victorkolesnyk/trickymonkey/yacht/README.md

# ВК-90: вітрильний крейсер 9,0 м із фанери

Робочий шифр ВК-90. Стан: ескізний проєкт, ревізія 0, не для виробництва.

- `docs/01_tekhnichne_zavdannia.md`: технічне завдання і відкриті питання
- `docs/02_plan_proiektu.md`: етапи, строки, реєстр документів
- `docs/03_eskiznyi_rozrakhunok.md`: розміри, гідростатика, маси, остійність (генерується скриптом)
- `docs/04_rozrakhunok_etapu_2.md`: розгортність поясів, центрування, вітрила, розташування (генерується скриптом)
- `docs/05_verfi.md`: кандидати на побудову, ризики, рекомендовані дії
- `docs/06_zapyt_propozytsii.md`: проєкт листа верфям
- `docs/07_ostiinist_z_rubkoiu.md`: остійність з урахуванням рубки (генерується `calc/stage3.py`)
- `docs/08_navantazhennia_kil_vanty.md`: навантаження на кіль і ванти, сили за формулами ISO 12215-9:2012
- `drawings/VK90-002_*`, `VK90-003_*`: загальне розташування і вітрильне озброєння
- `drawings/VK90-020_*`: попередні контури розгорток, не для розкрою
- `drawings/VK90-001_*`: теоретичне креслення (pdf, png, dxf у міліметрах) і таблиця ординат (csv)
- `calc/hull.py`: параметрична модель корпусу
- `calc/run.py`: розрахунок і креслення етапу 1
- `calc/stage2.py`: розрахунок і креслення етапу 2 (запускає і етап 1)

Перерахунок: `pip install numpy scipy matplotlib ezdxf`, далі `cd calc && python3 stage3.py` (запускає всі етапи).
