victorkolesnyk/trickymonkey/yacht/docs/02_plan_proiektu.md

# ВК-90. План проєкту, ревізія 4

Дата: 12.11.2026. Дати є пропозицією і зсуваються, якщо затримується погодження попереднього етапу.

## Робочу документацію можна мати на початку березня 2027 року, якщо рішення за ТЗ будуть до 19.11.2026

| Етап | Зміст | Результат | Власник | Строк |
|---|---|---|---|---|
| 0 | Погодження ТЗ, відповіді на п'ять відкритих питань | підписане ТЗ, ревізія 1 | Віктор | 19.11.2026 |
| 1 | Ескізний проєкт: обводи, гідростатика, навантаження мас, остійність першого наближення | документи 03, ВК90-001 (виконано, ревізія 0) | Claude | 12.11.2026 |
| 2 | Загальне розташування, вітрильне озброєння, центрування, уточнення обводів, перевірка розгортності поясів | документ 04, ВК90-001 ревізія 1, ВК90-002, 003 (виконано 12.11.2026, ревізія 0, чекає погодження) | Claude, погоджує Віктор | 26.11.2026 |
| 3 | Конструкція за ISO 12215-5, кріплення кіля за ISO 12215-9, стерно за ISO 12215-8, рангоут, повна остійність і STIX за ISO 12217-2 | ВК90-010...019, розрахункові записки | Claude | 21.01.2027 |
| 4 | Робоча документація: розкрій на верстат, стапель, вузли, специфікація матеріалів, технологічна інструкція | ВК90-020...039, файли DXF | Claude, приймає верф | 04.03.2027 |
| 5 | Незалежна перевірка і пакет на реєстрацію | висновок інженера, комплект для Адміністрації судноплавства | зовнішній корабельний інженер, Віктор | 25.03.2027 |

Паралельно з етапом 0 Віктор або юрист перевіряє до 26.11.2026 три позначки [перевірити] з ТЗ за текстами наказу № 203 і постанови № 1381. Від відповіді залежить, чи потрібен призначений орган з оцінки відповідності і чи зростає бюджет етапу 5.

## Реєстр документів

| Шифр | Назва | Формат | Етап | Стан |
|---|---|---|---|---|
| 01 | Технічне завдання | md | 0 | ревізія 0 |
| 02 | План проєкту | md | 0 | ревізія 0 |
| 03 | Ескізний розрахунок | md | 1 | ревізія 0 |
| ВК90-001 | Теоретичне креслення, таблиця ординат | pdf, dxf, csv | 1 | ревізія 2 |
| 05 | Пошук верфі: кандидати, ризики, дії | md | 2-3 | ревізія 0 |
| 06 | Запит попередньої пропозиції на побудову, проєкт листа | md | 2-3 | чернетка, не надіслано |
| 07 | Остійність з рубкою і вільним диферентом | md | 3 | ревізія 1 |
| 08 | Навантаження на кіль і ванти, сили за ISO 12215-9:2012 | md | 3 | ревізія 1 |
| ВК90-002 | Загальне розташування | pdf, dxf | 2 | ревізія 0 |
| ВК90-003 | Вітрильне озброєння, центрування | pdf, dxf | 2 | ревізія 0 |
| 04 | Розрахунок етапу 2: розгортність, центрування, вітрила, розташування | md | 2 | ревізія 0 |
| ВК90-010 | Конструктивний мідель-шпангоут | pdf, dxf | 3 | не розпочато |
| ВК90-011 | Конструктивний поздовжній розріз, палуба | pdf, dxf | 3 | не розпочато |
| ВК90-012 | Розрахунок конструкції корпусу | md | 3 | не розпочато |
| ВК90-013 | Кіль, бульб, кріплення кіля | pdf, dxf, md | 3 | не розпочато |
| ВК90-014 | Стерновий пристрій | pdf, dxf | 3 | не розпочато |
| ВК90-015 | Рангоут і стоячий такелаж | pdf, md | 3 | не розпочато |
| ВК90-016 | Розрахунок остійності й непотоплюваності | md | 3 | не розпочато |
| ВК90-020 | Розгортки поясів обшивки, розкрій аркушів | dxf | 4 | попередні контури, не для розкрою |
| ВК90-021 | Перебірки, флори, шпангоутні рами, розкрій | dxf | 4 | не розпочато |
| ВК90-022 | Стапель і послідовність складання | pdf, dxf | 4 | не розпочато |
| ВК90-023 | Вузли й деталі | pdf | 4 | не розпочато |
| ВК90-030 | Специфікація матеріалів і обладнання | xlsx | 4 | не розпочато |
| ВК90-031 | Технологічна інструкція | md, pdf | 4 | не розпочато |
| ВК90-032 | Схеми систем: електрична, паливна, водяна, осушувальна | pdf | 4 | не розпочато |
| ВК90-040 | Посібник власника | md, pdf | 5 | не розпочато |

## Стан після етапу 2 і що переходить на етап 3

Кільову лінію згладжено, кривина тепер одного знака по всій довжині. Пояси обшивки розгортні на більшій частині довжини, стрілка прогину шпангоутних відрізків не перевищує 11 мм. Непідтвердженою лишилася кормова ділянка: 0,67 м днищевого поясу, 0,43 м скулового, а на бортовому поясі твірні сходяться в точку на палубній лінії приблизно за 1,3 м від транця. Наслідок: ординати корми ще зміняться на 5-15 мм, тому розкрій заборонено до ревізії 2 теоретичного креслення на початку етапу 3.

Центр вітрильності випереджає центр бічного опору на 15,1 % довжини по ватерлінії. У відкритих джерелах для шлюпів наводять 13-17 %, але це вторинне джерело, а не підручник, тому баланс має підтвердити корабельний інженер. Запас для корекції є: зсув щогли на 0,30 м у корму зменшує випередження приблизно на 3,7 пункту.

Площа вітрил зменшилася з 44 до 42,7 м2, бо серп грота обмежено ахтерштагом. Кут Делленбау 8,9° означає жорстку яхту, тож на етапі 3 можна розглянути довшу щоглу, якщо замовник хоче кращий хід у слабкий вітер.

Не зроблено на етапі 2: остійність із рубкою і кутом заливання, гідростатика з диферентом, перевірка розташування на ергономіку (проходи, висота над койками). Маси статей досі є припущеннями з похибкою близько 10 %.

## Стан на 13.11.2026

Замовник погодив етап 2 без змін: розташування, висоту рубки 0,67 м і щоглу без подовження. Етап 3 розпочато з остійності: з урахуванням об'єму рубки кут заходу діаграми зріс зі 118° до 135° за мінімального навантаження і зі 116° до 132° за повного (документ 07).

Розрахунок конструкції за ISO 12215-5, 12215-8 і 12215-9 заблоковано: тексти стандартів платні, а відтворювати коефіцієнти з пам'яті я не буду. Потрібна дія: Віктор до 27.11.2026 купує чинні редакції ISO 12215-5, ISO 12215-9 і ISO 12217-2 або доручає цю частину корабельному інженеру, який їх має. До того часу Claude виконує роботи, що від стандартів не залежать: ревізію 2 обводів корми, остійність із диферентом, навантаження на кіль від перших принципів.

Пошук верфі описано в документі 05. Готового виконавця під фанерно-епоксидний корпус в Україні не знайдено, є шість кандидатів для звернення.

## Стан після робіт без стандартів, 13.11.2026

Обводи корми виправлено в ревізії 2 теоретичного креслення: кормові ділянки кільової лінії та вилиць тепер мають сталу кривину замість нульової на транці. Усі три пояси розгортні по всій довжині, твірні не перетинаються, стрілка прогину шпангоутних відрізків від 5 до 14 мм. Зауваження про непідтверджену корму з розділу про етап 2 знято. Заборона на розкрій лишається з іншої причини: товщини обшивки не підтверджено розрахунком конструкції, а розгортки ще не розкладено на аркуші.

Остійність з рубкою і вільним диферентом: кут заходу 136° за мінімального навантаження і 133° за повного. Диферент змінює результат на 1°, тож спрощення попередніх ревізій було допустимим.

Кріплення кіля перевірено за порядком величин: п'ять пар болтів M20 мають запас до межі плинності 11 у положенні на борту і від 2,7 до 5,3 при ударі об ґрунт на 6 вузлах. Число болтів остаточно визначить ISO 12215-9.

Усе, що можна було зробити на етапі 3 без текстів стандартів, виконано. Далі етап стоїть до виконання дії з попереднього розділу: придбання ISO 12215-5, 12215-9 і 12217-2 або залучення інженера.

## Отримано доповідь про ISO 12215-9, 13.11.2026

Замовник надав доповідь Lyons та ін. (HPYD8, 2024) про перегляд ISO 12215-9. Це не текст стандарту, але в ній є формули сил шести розрахункових випадків редакції 2012 року і формула попереднього затягу болтів. Документ 08 перераховано за ними: найбільше зусилля на болт становить 12,2 кН, тобто 16 % від попереднього затягу, запас до межі плинності не менший за 9.

Доповідь не знімає блокування етапу 3. У ній немає допустимих напружень, точок прикладання сил, методики розрахунку флорів і підкладних пластин. Потреба в ISO 12215-5 і ISO 12217-2 лишається повною, в ISO 12215-9 частковою. Додатковий висновок з доповіді: нова редакція 12215-9 очікувалася у 2025 році й робить розрахунок на втому обов'язковим. [перевірити] чи вона вже опублікована, щоб купувати чинну редакцію, а не редакцію 2012 року.
