victorkolesnyk/trickymonkey/yacht/docs/08_navantazhennia_kil_vanty.md

# ВК-90. Навантаження на кіль і ванти, ревізія 1

Файл згенеровано скриптом `calc/stage3.py`, вручну не редагувати.

Сили розрахункових випадків узято з формул ISO 12215-9:2012, наведених у доповіді Lyons, Bird, Hinterhoeller, Hoffmeister, Souppez «Regulatory Developments in Structural Keel Design: A Revised ISO 12215-9» (8th High Performance Yacht Design Conference, Окленд, 21-22.03.2024). Доповідь не містить допустимих напружень, коефіцієнтів запасу, точок прикладання сил і методики розрахунку флорів, тому це не розрахунок за стандартом, а перевірка болтів на його навантаження. Прийнята конструкція кріплення є припущенням.

## Прийнята конструкція

Сталевий зварний плавник з обшивкою 8 мм (S235), товщина профілю 110 мм, фланець завширшки 300 мм. Кріплення: 5 пар болтів M20 класу A4-70 у два ряди через 220 мм, крок 220 мм. Маса кіля 1450 кг, маса яхти в повному навантаженні 4633 кг, розмах кіля від кореня до низу 1,13 м.

## Сили розрахункових випадків

| Випадок ISO 12215-9:2012 | Формула | Сила, кН |
|---|---|---|
| 1. Фіксований кіль при крені 90° | F1 = g·mK | 14,2 |
| 3. Вертикальний удар знизу | F3 = g·(mLDC − mK) | 31,2 |
| 4. Поздовжній удар | F4 = 1,2·g·(mLDC − mK) | 37,5 |
| 4, поперечна складова (пропозиція до нової редакції) | F4Y = λ·F4, λ від 0,17 до 0,375 | 6,4 - 14,1 |

Випадки 2, 5 і 6 стосуються поворотних кілів і швертів і до ВК-90 не застосовуються.

## Зусилля в болтах

Попередній затяг болта за формулою FPS = 0,7·σy·Sn: 77,2 кН (площу шийки прийнято рівною розрахунковій площі різьби 245 мм2).

| Випадок | Момент у корені, кН·м | Зусилля на найнавантаженіший болт, кН | Напруження, МПа | Запас до межі плинності | Частка від попереднього затягу |
|---|---|---|---|---|---|
| 1. Крен 90° | 12,6 | 9,7 | 40 | 11,4 | 13 % |
| 4. Поздовжній удар, сила на низу кіля | 42,4 | 10,5 | 43 | 10,5 | 14 % |
| 4, поперечна складова, λ = 0,17 | 7,2 | 5,5 | 23 | 19,9 | 7 % |
| 4, поперечна складова, λ = 0,375 | 15,9 | 12,2 | 50 | 9,0 | 16 % |

Найбільше зовнішнє зусилля на болт становить 16 % від попереднього затягу, тож стик під цими навантаженнями не розкривається. Випадок 3 болтів не розтягує: сила 31,2 кН притискає фланець до днища і має бути сприйнята кільовими флорами.

Напруження в обшивці плавника біля кореня у випадку 1: 21 МПа, запас до межі плинності 11,3.

## Власна жорсткіша перевірка удару об ґрунт

Сила з умови зупинки маси яхти з 6 вузлів на заданому шляху. Шлях зупинки є припущенням.

| Шлях зупинки, м | Сила на низ кіля, кН | Відношення до F4 стандарту | Зусилля на передній болт, кН | Запас до межі плинності |
|---|---|---|---|---|
| 0,30 | 74 | 2,0 | 20,6 | 5,3 |
| 0,15 | 147 | 3,9 | 41,2 | 2,7 |

## Що лишається невиконаним

Болти не є слабкою ланкою. Не перевірено: фанерне днище під фланцем, підкладні пластини, кільові флори та їх з'єднання з обшивкою, втома зварних швів плавника. Доповідь окремо попереджає, що нова редакція стандарту робить розрахунок на втому обов'язковим і що тонка обшивка під товстою підкладною пластиною є ризикованим рішенням. Для цих перевірок потрібен повний текст ISO 12215-9 і ISO 12215-5.

## Ванти

| Величина | Значення |
|---|---|
| Найбільший відновлювальний момент (повне навантаження) | 34,0 кН·м |
| Напівширина по вант-путенсах | 1,47 м |
| Вертикальне зусилля на вант-путенс навітряного борту | 23,2 кН |

Це статична оцінка без коефіцієнта динамічності. Навантаження на рангоут нормує ISO 12215-10, тексту якого немає.
