victorkolesnyk/trickymonkey/yacht/docs/03_eskiznyi_rozrakhunok.md

# ВК-90. Ескізний розрахунок, ревізія 0

Файл згенеровано скриптом `calc/run.py`. Усі числа походять з моделі `calc/hull.py`, вручну не редагувати.

## Головні розміри

| Параметр | Значення |
|---|---|
| Довжина корпусу | 9,00 м |
| Найбільша ширина | 3,11 м |
| Довжина по КВЛ | 8,05 м |
| Ширина по КВЛ | 2,76 м |
| Осадка корпусом | 0,47 м |
| Осадка повна | 1,60 м |
| Висота борту на міделі над КВЛ | 0,93 м |
| Водотоннажність порожнем | 3848 кг |
| Водотоннажність на КВЛ (розрахункова) | 4350 кг |
| Водотоннажність у повному навантаженні | 4633 кг |
| Баласт | 1450 кг, 33 % від розрахункової |
| Площа вітрил (грот і стаксель, попередньо) | 43 м2 |

## Гідростатика на КВЛ

| Параметр | Значення |
|---|---|
| Об'ємна водотоннажність | 4,24 м3 |
| Абсциса центра величини від транця | 3,96 м (0,8 % LWL у корму від середини КВЛ) |
| Апліката центра величини KB | 0,28 м |
| Поперечний метацентричний радіус BM | 2,00 м |
| Площа ватерлінії | 17,45 м2 |
| Абсциса центра площі ватерлінії | 3,71 м |
| Змочена поверхня корпусу без виступних частин | 18,7 м2 |
| Призматичний коефіцієнт | 0,563 |
| Коефіцієнт загальної повноти (корпус) | 0,391 |
| Коефіцієнт повноти ватерлінії | 0,787 |
| Маса на 1 см осадки | 179 кг |

## Безрозмірні показники

| Показник | Значення | Що це означає |
|---|---|---|
| Відносна водотоннажність D/L | 232 | помірно важкий крейсер |
| Енергоозброєність SA/D | 16,3 | крейсерський рівень |
| Відношення LWL/BWL | 2,92 | широкий корпус, великий житловий об'єм |

## Навантаження мас порожнем

| Стаття | Маса, кг | Апліката ЦМ від ОЛ, м |
|---|---|---|
| Обшивка корпусу (фанера, склотканина, епоксид) | 340 | 0,65 |
| Палуба, рубка, кокпіт | 190 | 1,55 |
| Перебірки, флори, стрингери, шпангоутні рами | 350 | 0,75 |
| Внутрішнє обладнання приміщень | 300 | 0,75 |
| Підкріплення під кіль, кільові флори | 100 | 0,10 |
| Плавник кіля (сталь) | 300 | -0,45 |
| Бульб кіля (свинець) | 1150 | -1,00 |
| Рангоут, такелаж, вітрила | 190 | 6,00 |
| Двигун із приводом, паливна система | 170 | 0,35 |
| Електрообладнання, акумулятори | 120 | 0,60 |
| Палубне обладнання, якірний пристрій | 200 | 1,30 |
| Суднові системи, камбуз, гальюн, цистерни | 120 | 0,60 |
| Стерновий пристрій | 60 | 0,40 |
| Шпаклювання, фарбування | 80 | 0,70 |
| Запас маси 8 % (без баласту) | 178 | 0,90 |
| Разом порожнем | 3848 | 0,41 |

Маси статей є припущеннями першого наближення, а не результатом зважування чи специфікації. Уточнення відбувається на етапах 2 і 3.

## Остійність

| Стан | Маса, кг | KG, м | GM, м | GZ при 30°, м | GZ max, м | Кут GZ max | Кут заходу діаграми | Площа під GZ, м·рад |
|---|---|---|---|---|---|---|---|---|
| Мінімальне навантаження | 4058 | 0,45 | 1,84 | 0,65 | 0,77 | 50° | 118° | 1,05 |
| Повне навантаження | 4633 | 0,50 | 1,76 | 0,63 | 0,74 | 50° | 116° | 0,98 |
| Чутливість: KG вище на 0,10 м | 4058 | 0,55 | 1,74 | 0,60 | 0,70 | 50° | 113° | 0,91 |
| Альтернатива: два скулові кілі, осадка 1,15 м | 4058 | 0,63 | 1,68 | 0,57 | 0,69 | 55° | 108° | 0,82 |

Таблиця плечей GZ, м:

| Кут | 0° | 10° | 20° | 30° | 40° | 50° | 60° | 70° | 80° | 90° | 100° | 110° | 120° | 130° | 140° | 150° | 160° | 170° | 180° |
|---|---|---|---|---|---|---|---|---|---|---|---|---|---|---|---|---|---|---|---|
| Мін. навантаження | 0,00 | 0,31 | 0,53 | 0,65 | 0,73 | 0,77 | 0,76 | 0,72 | 0,61 | 0,46 | 0,30 | 0,14 | -0,03 | -0,19 | -0,33 | -0,44 | -0,49 | -0,42 | -0,00 |
| Повне навантаження | 0,00 | 0,30 | 0,51 | 0,63 | 0,71 | 0,74 | 0,72 | 0,68 | 0,56 | 0,41 | 0,26 | 0,10 | -0,06 | -0,21 | -0,34 | -0,43 | -0,47 | -0,38 | -0,00 |
