victorkolesnyk/trickymonkey/yacht/docs/04_rozrakhunok_etapu_2.md

# ВК-90. Розрахунок етапу 2, ревізія 0

Файл згенеровано скриптом `calc/stage2.py`, вручну не редагувати.

## Розгортність поясів обшивки

Для кожного поясу шукаються твірні розгортної поверхні між двома граничними кривими. Покриття показує частку довжини поясу, де твірну знайдено. Стрілка прогину показує, наскільки розгортна поверхня відходить від прямих шпангоутних відрізків теоретичного креслення.

| Пояс | Без твірних у кормі, м | Без твірних у носі, м | Без твірних усередині, м | Твірні не перетинаються | Стрілка прогину, мм | Площа одного поясу, м2 | Габарит розгортки, м | Найбільша ширина поясу, м |
|---|---|---|---|---|---|---|---|---|
| Днищевий пояс | 0,00 | 0,00 | 0,00 | так | 14 | 7,80 | 8,50 x 1,16 | 2,41 |
| Скуловий пояс | 0,00 | 0,00 | 0,00 | так | 8 | 3,71 | 8,63 x 0,68 | 1,64 |
| Бортовий пояс | 0,00 | 0,00 | 0,00 | так | 5 | 7,49 | 9,14 x 1,43 | 1,07 |

Площа обшивки корпусу без транця: 38,0 м2, центр площі на 4,08 м від транця. Маса обшивки за прийнятих у навантаженні 340 кг відповідає 8,9 кг/м2.

## Поздовжнє центрування

| Стан | Маса, кг | ЦМ від транця, м | ЦВ від транця, м | Диферент на довжині КВЛ, см |
|---|---|---|---|---|
| Порожнем | 3848 | 4,09 | 3,99 | 4,9 на ніс |
| Мінімальне навантаження | 4058 | 3,99 | 3,97 | 0,7 на ніс |
| Повне навантаження | 4633 | 3,92 | 3,94 | 1,3 на корму |

Кіль стоїть на 4,00 м від транця, щогла на 5,20 м, дизель на 2,55 м. Диферент оцінено через поздовжню метацентричну висоту, без перерахунку гідростатики з диферентом.

## Вітрильне озброєння

| Параметр | Значення |
|---|---|
| P (передня шкаторина грота) | 11,20 м |
| E (нижня шкаторина грота) | 4,00 м |
| I (висота переднього трикутника) | 10,60 м |
| J (основа переднього трикутника) | 3,30 м |
| Грот із серпом (6 % понад трикутник) | 23,7 м2 |
| Стаксель 108 % | 19,0 м2 |
| Разом | 42,7 м2 |
| SA/D на КВЛ | 16,3 |
| Топ щогли над КВЛ | 13,7 м |
| Довжина щогли від даху рубки | 12,1 м |
| Центр вітрильності (грот і передній трикутник) | 4,93 м від транця, 5,36 м над КВЛ |
| Центр бічного опору (корпус, кіль, бульб, стерно) | 3,72 м від транця, 0,49 м під КВЛ |
| Площа бічного опору | 4,10 м2 |
| Випередження центра вітрильності | 15,1 % довжини по КВЛ |
| Кут Делленбау (крен від тиску 47,9 Па на всю площу) | 8,9° |

## Загальне розташування

| Параметр | Значення |
|---|---|
| Перебірка ахтерпіка | 0,40 м від транця |
| Перебірка рубки (вхід) | 2,60 м від транця |
| Головна перебірка (під щоглою) | 5,20 м від транця |
| Перебірка носової каюти | 6,25 м від транця |
| Таранна перебірка | 8,30 м від транця |
| Висота в кают-компанії біля входу | 1,85 м |
| Висота в кают-компанії біля головної перебірки | 1,78 м |
| Ширина пайола на міделі | 1,68 м |
| Диван-койки кают-компанії | 1,90 x 1,00 м |
| Носова двоспальна койка | довжина 2,05 м, ширина 2,38 м в головах, 0,50 м у ногах |
| Кокпіт | довжина 2,20 м, ширина дна 1,20 м |
