victorkolesnyk/trickymonkey/yacht/docs/07_ostiinist_z_rubkoiu.md

# ВК-90. Остійність з рубкою і вільним диферентом, ревізія 1

Файл згенеровано скриптом `calc/stage3.py`, вручну не редагувати.

Рубка врахована як водонепроникний об'єм. Диферент на кожному куті крену знайдено з умови рівноваги. Кокпіт і кут заливання не враховано. Плоска палуба без рубки показана для порівняння. Базові значення без рубки перераховано для обводів ревізії 2.

| Стан | Маса, кг | KG, м | Кут заходу: без рубки | з рубкою, без диферента | з рубкою, з диферентом | GZ max з диферентом, м | Кут GZ max | Диферент при 90°, градуси |
|---|---|---|---|---|---|---|---|---|
| Мінімальне навантаження | 4058 | 0,45 | 118° | 135° | 136° | 0,75 | 50° | 3,5 |
| Повне навантаження | 4633 | 0,50 | 116° | 132° | 133° | 0,72 | 50° | 3,0 |

Додатний диферент означає занурення носа. Точок без збіжності розв'язку: 0, 0.

Плечі GZ з рубкою і диферентом, м:

| Кут | 0° | 10° | 20° | 30° | 40° | 50° | 60° | 70° | 80° | 90° | 100° | 110° | 120° | 130° | 140° | 150° | 160° | 170° | 180° |
|---|---|---|---|---|---|---|---|---|---|---|---|---|---|---|---|---|---|---|---|
| Мінімальне навантаження | 0,00 | 0,31 | 0,52 | 0,64 | 0,72 | 0,75 | 0,74 | 0,71 | 0,62 | 0,53 | 0,43 | 0,32 | 0,19 | 0,07 | -0,04 | -0,12 | -0,11 | -0,05 | 0,00 |
| Повне навантаження | 0,00 | 0,29 | 0,50 | 0,61 | 0,70 | 0,72 | 0,70 | 0,67 | 0,58 | 0,50 | 0,39 | 0,27 | 0,15 | 0,03 | -0,07 | -0,14 | -0,13 | -0,08 | 0,00 |
