victorkolesnyk/trickymonkey/yacht/docs/05_verfi.md

# ВК-90. Пошук верфі, ревізія 0

Дата: 13.11.2026. Джерело даних: відкритий вебпошук 13.11.2026. Сайти верфей і каталогів з робочого середовища недоступні, тому чинність контактів і сам факт роботи кожної верфі у 2026 році не підтверджено. Жодній верфі я не писав і не телефонував.

## Готової верфі під фанерно-епоксидний крейсер 9 м в Україні пошук не знайшов

Українські яхтові верфі, які видно у відкритих джерелах, будують зі сталі, алюмінію або склопластику. Підтвердженого виконавця, який на замовлення будує кілеві яхти з фанери на епоксиді, серед них немає. Наслідок: будівника доведеться не обирати з каталогу, а збирати з двох частин, тобто конструктора з досвідом фанерних корпусів і майстерні з верстатом та теплим цехом.

Більшість знайдених верфей стоїть у Миколаєві й Херсоні. Це прифронтові міста, тому до технічних критеріїв додається безпековий: ризик для цеху, строків і страхування вантажу.

## Кандидати за спаданням придатності

| Номер | Кандидат | Місто | Що підтверджено пошуком | Придатність | Головний ризик |
|---|---|---|---|---|---|
| 1 | Юрій Ніколенко, Unik Yachts | Миколаїв | проєктує вітрильні яхти й катери 5-10 м, фанера з розкроєм на верстаті, передає креслення верфям і приватним замовникам, працює в MAXSURF (інтерв'ю yacht.de, травень 2024) | найвища: той самий розмір і та сама технологія; може бути і перевіряльником проєкту, і провідником до майстерень, які вже будували за його кресленнями | власної верфі у джерелах не видно; чи бере чужі проєкти на перевірку, невідомо |
| 2 | Otis Tarda | імовірно Львів (одне вторинне джерело) | ліцензований будівник серійної яхти L30 завдовжки 30 футів, основний профіль: композитні деталі для авіації, авто і медицини; сайт otis-tarda.com | висока за розміром, культурою виробництва і розташуванням далеко від фронту | фанера не їхній матеріал; за звітом класу у 2025 році збудовано 1 човен, тож зацікавленість в одиничному замовленні невідома |
| 3 | Яхт-верф «Вокруг Света» | Миколаїв | вітрильні яхти й катери приблизно від 7 до 30 м, склопластик і сталь, є модель 8 м; сайт aw.mk.ua | середня: розмір підходить, досвід оснащення вітрильних яхт є | стан у 2026 році не підтверджено; фанера не основний матеріал |
| 4 | Kruz Yachts (ТОВ «Круз-яхт») | Херсон | на ринку з 2002 року, починали з дерев'яних вітрильних човнів, з 2009 року склопластик, моделі 2-14 м | середня за досвідом з деревом | Херсон під постійними обстрілами; чи працює виробництво, невідомо |
| 5 | Black Sea Yachts (ТОВ «Верф «Чорноморські яхти») | Миколаїв | проєктування і побудова вітрильних яхт зі сталі й алюмінію до 30 м, сертифікація в RINA; сайт blackseayachts.com | низька для фанери; висока, якщо змінити матеріал корпусу на алюміній | зміна матеріалу означає переробку проєкту від етапу 1 |
| 6 | Flagman Yachts | Миколаїв | яхти 17-40 м, згадано реконструкцію дерев'яних суден | низька: замалий для них об'єкт | стан у 2026 році не підтверджено |

Відсіяно: Sailmark у Новій Каховці (місто окуповане), Gemond у Дніпрі (сталеві моторні яхти), Чорноморська яхтова верф (сталь і алюміній, великі яхти), «Нібулон» (яхтовий напрям у джерелах подано як минулий).

## Вибір верфі змінює правовий режим і логістику

Якщо яхту будує верф на замовлення, виняток для суден власної побудови, найімовірніше, не діє, і для категорії B знадобиться оцінка відповідності за Технічним регламентом № 1381. Це досі позначка [перевірити] з технічного завдання, але тепер від неї залежить ціна договору: верф має знати, хто оплачує призначений орган.

Ширина 3,11 м робить корпус негабаритним вантажем. Якщо будувати у Львові, а спускати на Дніпрі чи в Одесі, перевезення стає окремою статтею бюджету. [перевірити] чинні воєнні обмеження на плавання маломірних суден у Чорному морі та на Дніпрі: від них залежить, де яхту взагалі можна буде спустити й експлуатувати.

## Рекомендовані дії

1. Віктор до 20.11.2026 пише Юрію Ніколенку з двома питаннями: чи візьме незалежну перевірку проєкту ВК-90 і які майстерні будували фанерні корпуси за його кресленнями. Це закриває одразу і етап 5 плану, і пошук будівника.
2. Віктор до 20.11.2026 надсилає запит пропозиції (документ 06) в Otis Tarda і «Вокруг Света». Мета першого кола: не ціна, а відповідь «беремо чи ні» і умови.
3. Віктор до 27.11.2026 визначає бажане місце спуску і стоянки. Без цього не можна порівнювати верфі за логістикою.
4. Claude після відповідей верфей зводить пропозиції в таблицю порівняння: ціна, строк, цех, досвід, відстань до місця спуску.

Якщо жодна з трьох адрес не відповість до 04.12.2026, залишаються два шляхи: майстерня без яхтового досвіду під наглядом конструктора або верф у Польщі чи країнах Балтії, де фанерно-епоксидне будівництво поширеніше. Другий шлях я не досліджував.

## Джерела

- https://www.yacht.de/en/special/people/interview-modern-boatbuilding-in-ukraine-in-times-of-war/
- https://en.sudohodstvo.org/yuriy-nikolenko-unik-yachts-first-company-presented-shipbuilding-ukraine-sailing-magazine/
- https://www.giornaledellavela.com/2023/03/19/war-does-not-stop-ukraine-the-secret-weapon-is-a-sailboat/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
- https://media.sailing.org/sailing/wp-content/uploads/2026/02/10100703/2025-Class-Report-L30-3.pdf
- https://www.yachtall.com/en/boat-builders-shipyards/ukraine
- https://itboat.com/shipyards/1593-vokrug-sveta
- http://www.aw.mk.ua/
- https://itboat.com/shipyards/1319-kruz-yachts
- https://blackseayachts.com/ua/sailing-yachts
- https://itboat.com/shipyards/1819-flagman-yachts
- https://www.profinautic.com/en/manufacturers/boats/?boatcat=16
