victorkolesnyk/trickymonkey/yacht/docs/01_tekhnichne_zavdannia.md

# ВК-90. Технічне завдання, ревізія 1

Дата: 12.11.2026, ревізія 1 враховує відповіді замовника щодо двигуна, спальних місць і озброєння. Статус: проєкт для погодження замовником.

## Замовник обрав морський кілевий крейсер завдовжки 9 м із фанери

Відповіді з опитування 12.11.2026:

| Питання | Рішення замовника |
|---|---|
| Тип і розмір | кілевий крейсер, довжина корпусу близько 9 м, ширина 3,0-3,2 м |
| Матеріал і технологія | морська фанера, шиття і склеювання, епоксидна смола, склотканина |
| Район плавання | відкрите море |
| Будівник | майстерня або верф |
| Тип кіля | на розсуд проєктанта |
| Формальна відповідність | пакет під реєстрацію в Україні |
| Пріоритет | комфорт і житловий об'єм |

## Проєктні рішення, які з цього випливають

Корпус має гострі вилиці, по три пояси обшивки на борт, бо шиття і склеювання потребує поверхонь, що розгортаються на площину. Ширина 3,11 м означає, що дорогами яхта перевозиться лише як негабаритний вантаж, тож стоянка буде стаціонарною.

Кіль прийнято фіксований плавниковий зі свинцевим бульбом, осадка 1,60 м. Розрахунок у документі 03 показує кут заходу діаграми остійності 118° проти 108° у варіанта з двома скуловими кілями за тієї самої маси баласту. Для відкритого моря ці 10° є різницею між запасом і його відсутністю. Висновок зміниться, якщо порт приписки має глибини менші за 2 м: тоді треба або збільшувати баласт приблизно на 300 кг для скулових кілів, або переходити на підйомний кіль із баластом.

Ціль за категорією проєктування: B за ISO 12217-2 (вітер до 8 балів, значна висота хвилі до 4 м). Категорія підтверджується лише повним розрахунком на етапі 3, зараз це ціль, а не факт.

## Рішення замовника від 12.11.2026, ревізія 1

Двигун: стаціонарний дизель із приводом. Спальних місць: 4. Озброєння: дробовий шлюп.

## Що ще не вирішено і блокує етап 4

1. Розмір аркуша фанери і робочого поля верстата на верфі. Робоче припущення: 2500 x 1250 мм.
2. Хто саме будує. Це питання має правовий наслідок, описаний нижче, і визначає обсяг етапу 5.

## Правова рамка: що підтверджено і що ні

Підтверджено пошуком 12.11.2026:

- малі судна реєструються в Судновій книзі України, реєстрація засвідчується судновим білетом (стаття 35 Закону «Про внутрішній водний транспорт»);
- реєстрацію веде Адміністрація судноплавства за Порядком, затвердженим наказом Мінінфраструктури від 11.04.2022 № 203; серед документів потрібен документ, що підтверджує технічні характеристики судна;
- чинний Технічний регламент прогулянкових суден і водних мотоциклів затверджено постановою Кабінету Міністрів від 23.12.2021 № 1381, він побудований на Директиві 2013/53/ЄС.

Не підтверджено, бо сайти zakon.rada.gov.ua, marad.gov.ua і mindev.gov.ua недоступні з цього робочого середовища:

- [перевірити] повний перелік документів для судна індивідуальної побудови за наказом № 203;
- [перевірити] чи містить регламент № 1381 виняток для суден, побудованих для власного користування, і за яких умов. У Директиві 2013/53/ЄС такий виняток стосується судна, яке будує переважно сам майбутній користувач; судно, збудоване верф'ю на замовлення, під нього не підпадає. Якщо український регламент повторює цю норму, побудова на верфі означатиме повну оцінку відповідності для категорії B за участі призначеного органу. Це головний регуляторний ризик проєкту;
- [перевірити] числові критерії ISO 12217-2 для категорії B. Текст стандарту платний, у відкритому доступі є лише зміст.

## Обмеження цієї роботи

Розрахунки й креслення виконує мовна модель із програмним інструментарієм. Перед початком будівництва конструкцію корпусу, кріплення кіля, рангоут і остійність має перевірити й підписати дипломований корабельний інженер. Без цього документація не придатна ні для побудови морського судна, ні для подання на реєстрацію.
