victorkolesnyk/trickymonkey/yacht/drawings/VK90-001_teoretychne_kreslennia.pdf

## Бік

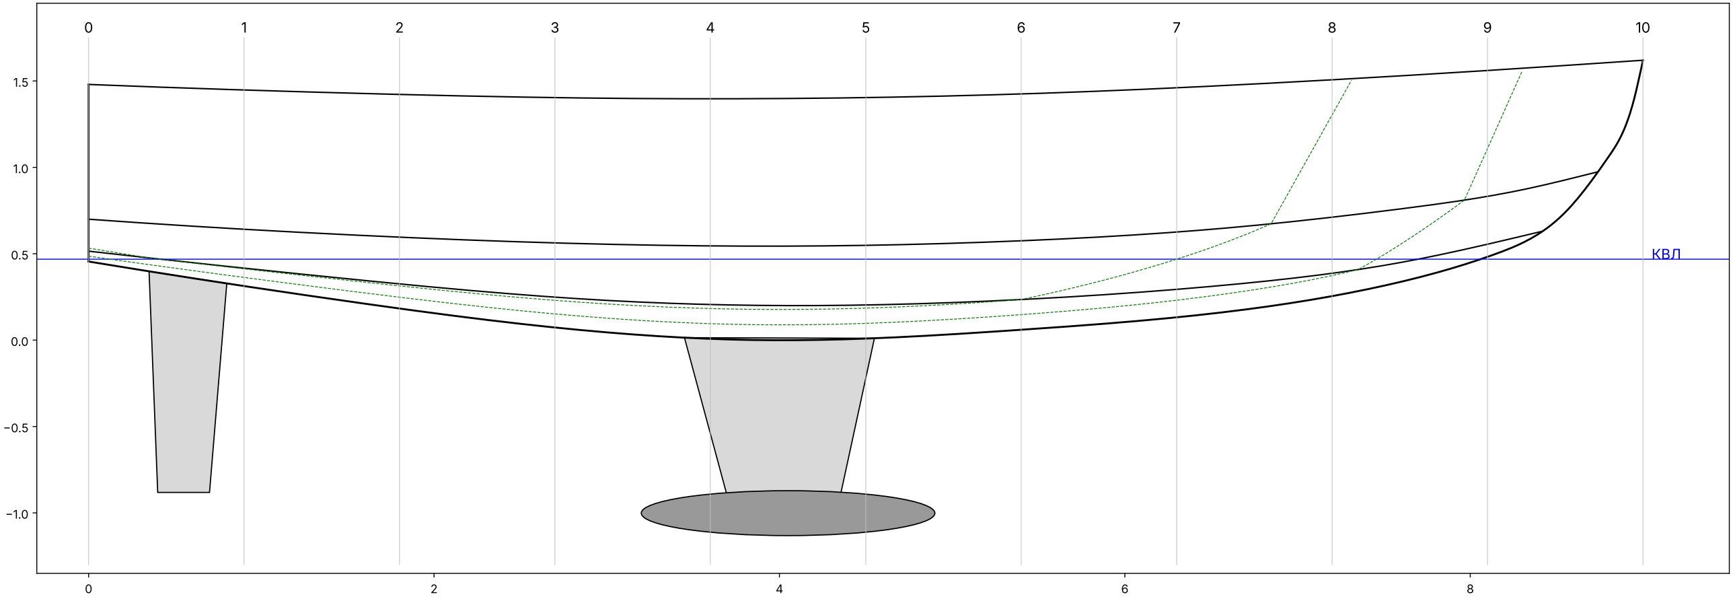
[picture p1: figure]
КВЛ
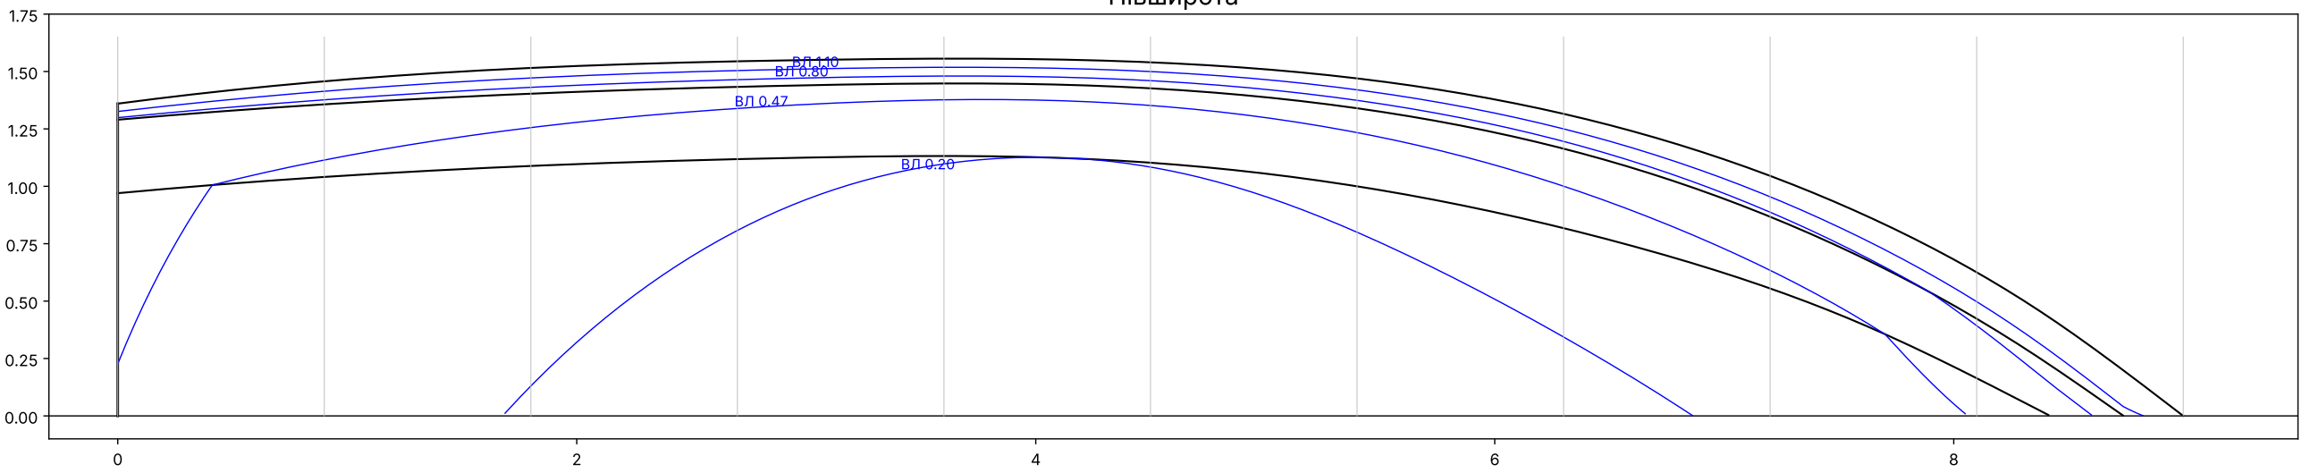
[picture p2: figure]

## Півширота

## Корпус (корма ліворуч, ніс праворуч)

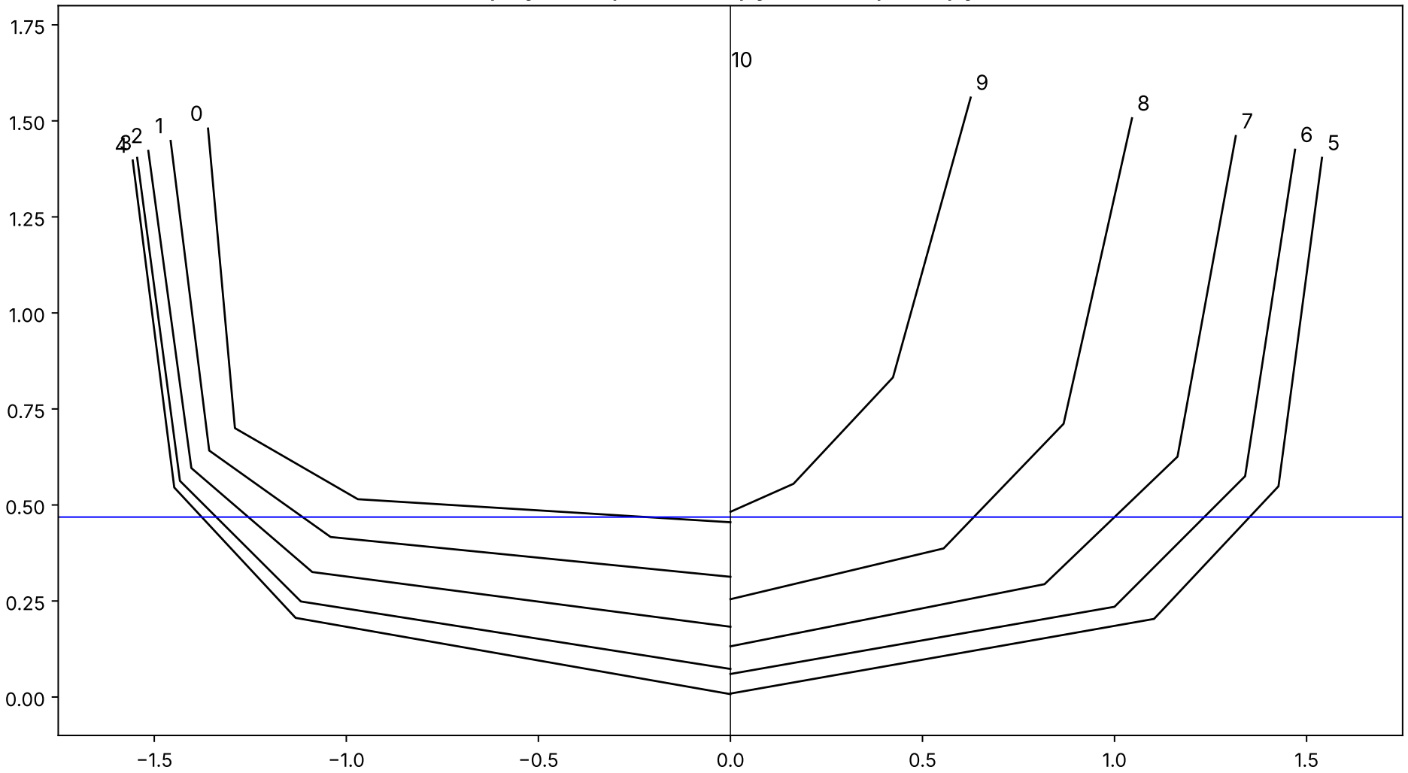
[picture p3: figure]

## Діаграма статичної остійності (плоска палуба, без рубки)

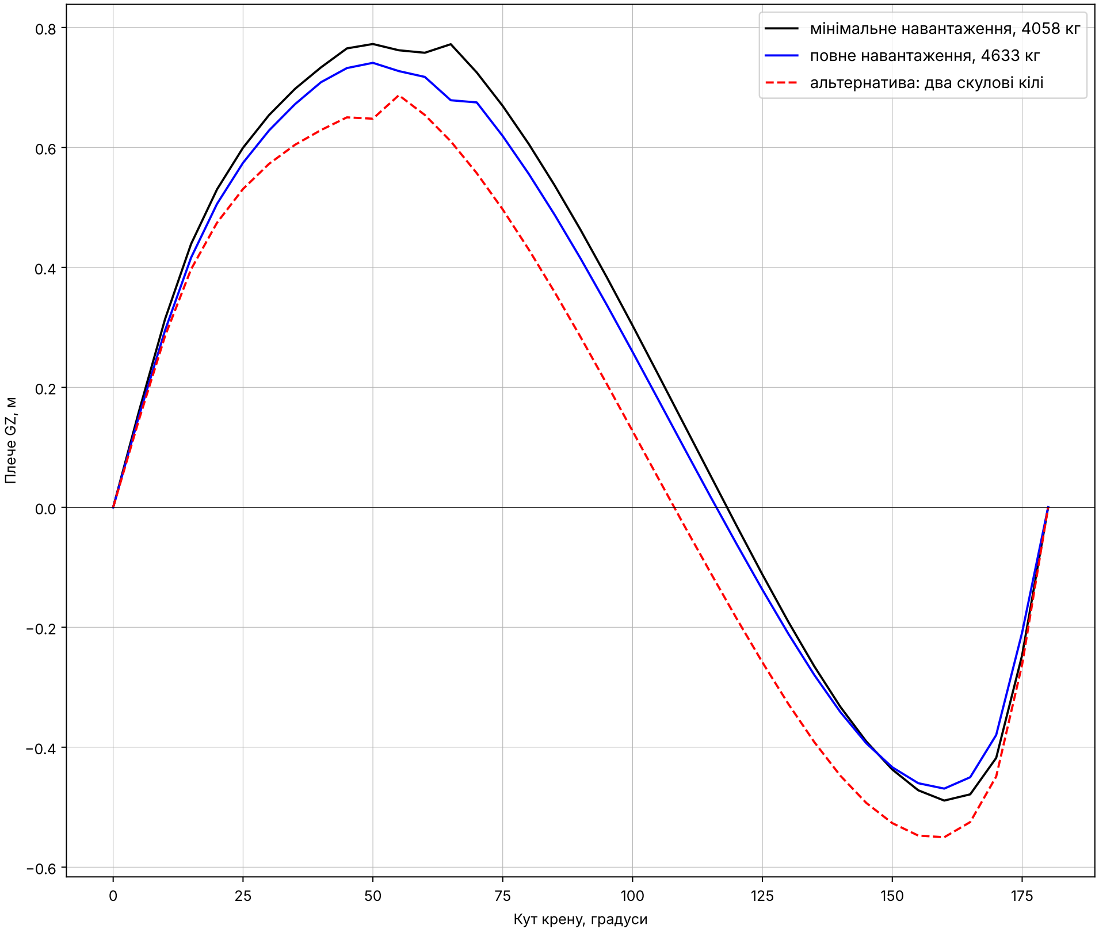
[picture p4: figure]
Кут крену, градуси; Плече GZ,; мінімальне навантаження, 4058 кг

повне навантаження, 4633 кг альтернатива: два скулові кілі

Довжина корпусу 9.00 м Найбільша ширина 3.11 м Довжина по КВЛ 8.05 м Ширина по КВЛ 2.76 м Осадка 1.60 м Водотоннажність на КВЛ 4350 кг

Документ ВК90-001, ревізія 0. Статус: ескіз для погодження, не для виробництва. Зелений пунктир: батокси 0,5 і 1,0 м. Сині лінії: ватерлінії.

ВК-90. Теоретичне креслення (ескізний проєкт, етап 1). Розміри в метрах. Шпація 0,9 м, шпангоути рахуються від транця
