victorkolesnyk/trickymonkey/yacht/drawings/VK90-003_vitrylne_ozbroiennia.pdf

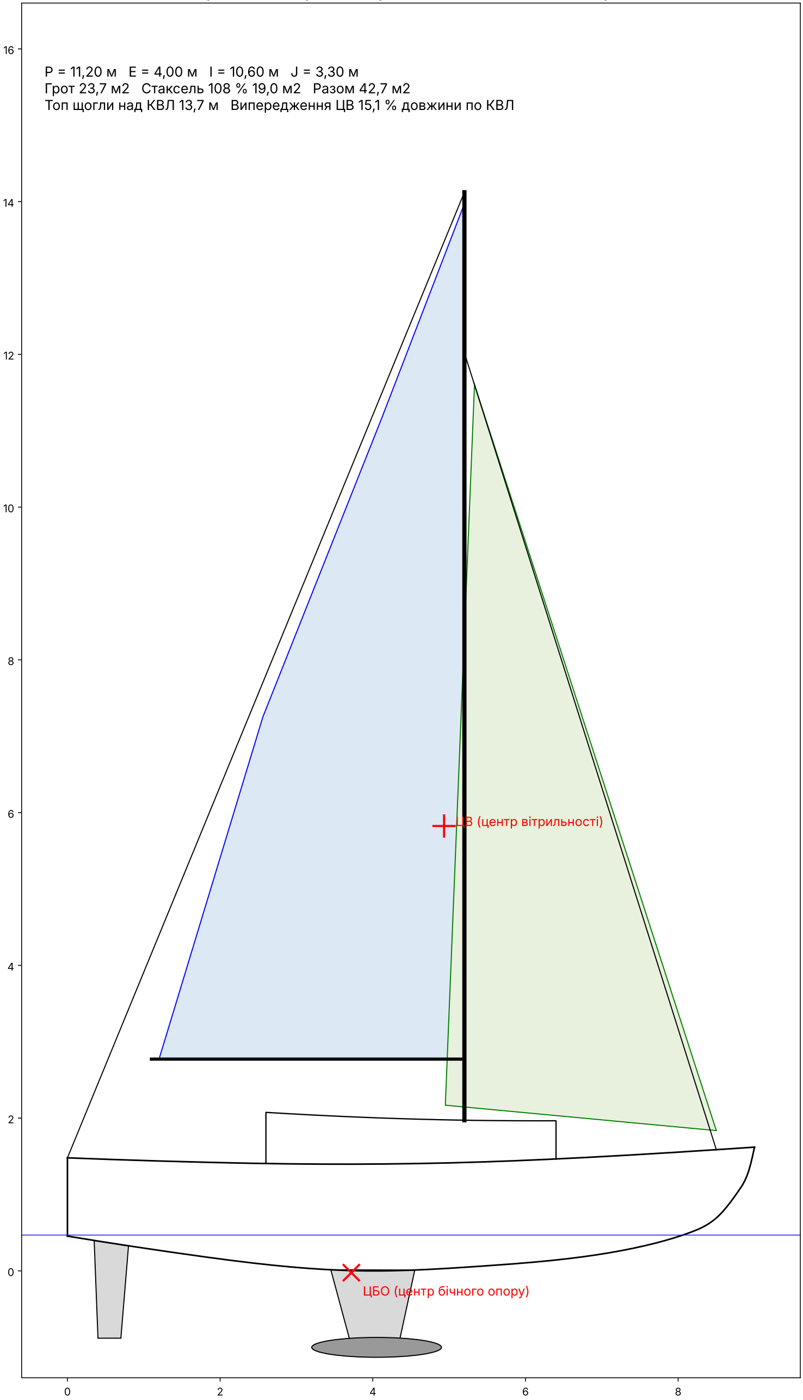
[picture p5: figure]
ЦВ (центр вітрильності); ЦБО (центр бічного опору)

P = 11,20 м E = 4,00 м I = 10,60 м J = 3,30 м
Грот 23,7 м2 Стаксель 108 % 19,0 м2 Разом 42,7 м2
Топ щогли над КВЛ 13,7 м Випередження ЦВ 15,1 % довжини по КВЛ

## ВК-90. Вітрильне озброєння, ревізія 0 (ескіз, не для виробництва)
