victorkolesnyk/trickymonkey/yacht/drawings/VK90-001_teoretychne_kreslennia.png

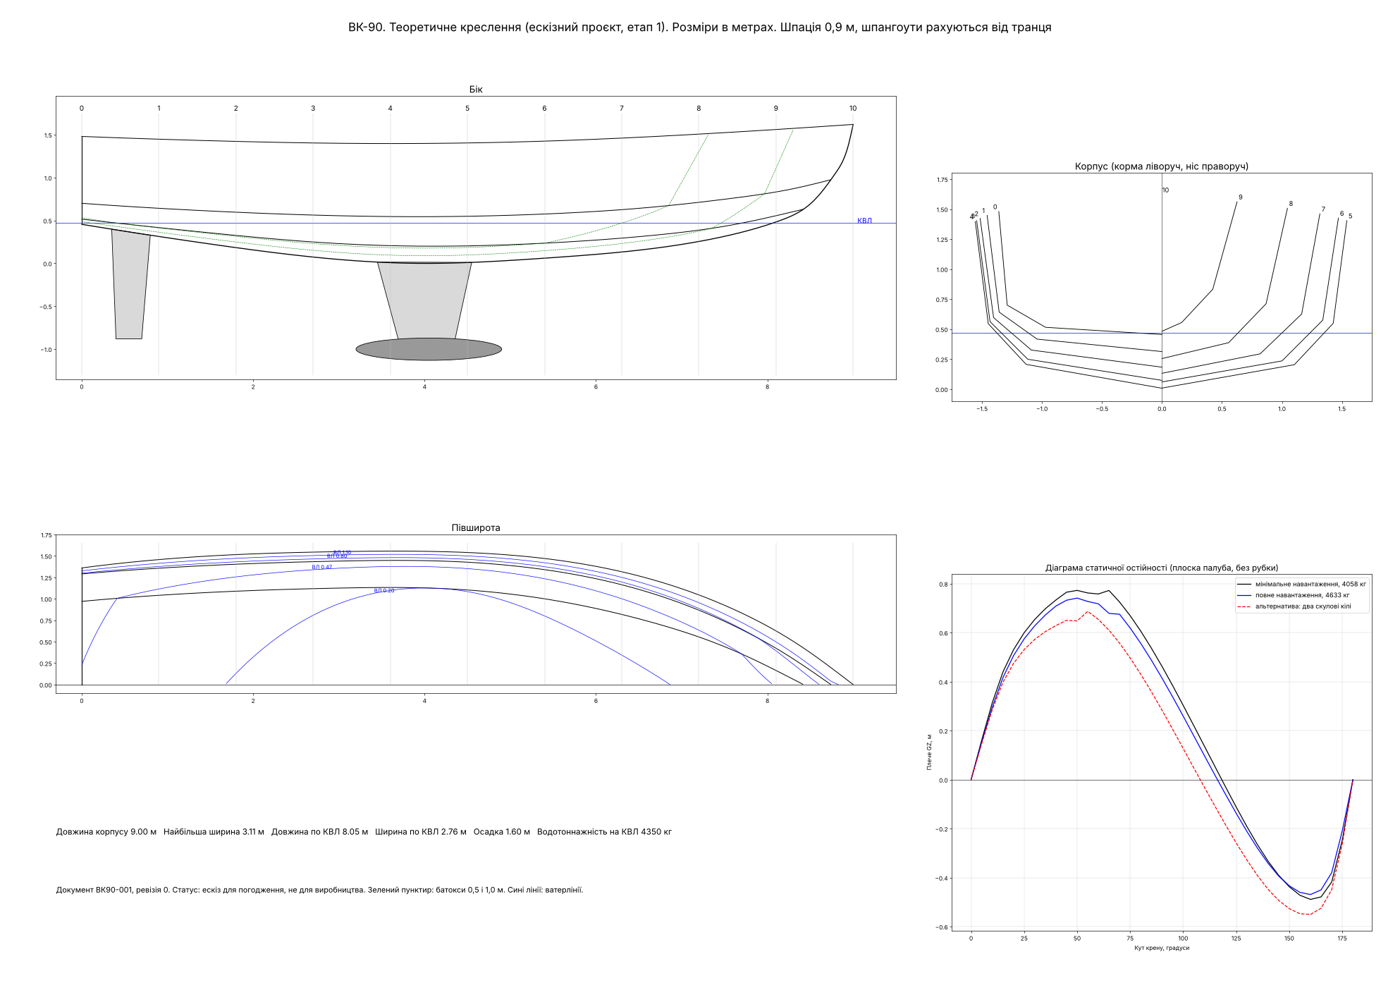
yacht/drawings/VK90-001_teoretychne_kreslennia.png
