victorkolesnyk/trickymonkey/yacht/drawings/VK90-002_zahalne_roztashuvannia.png

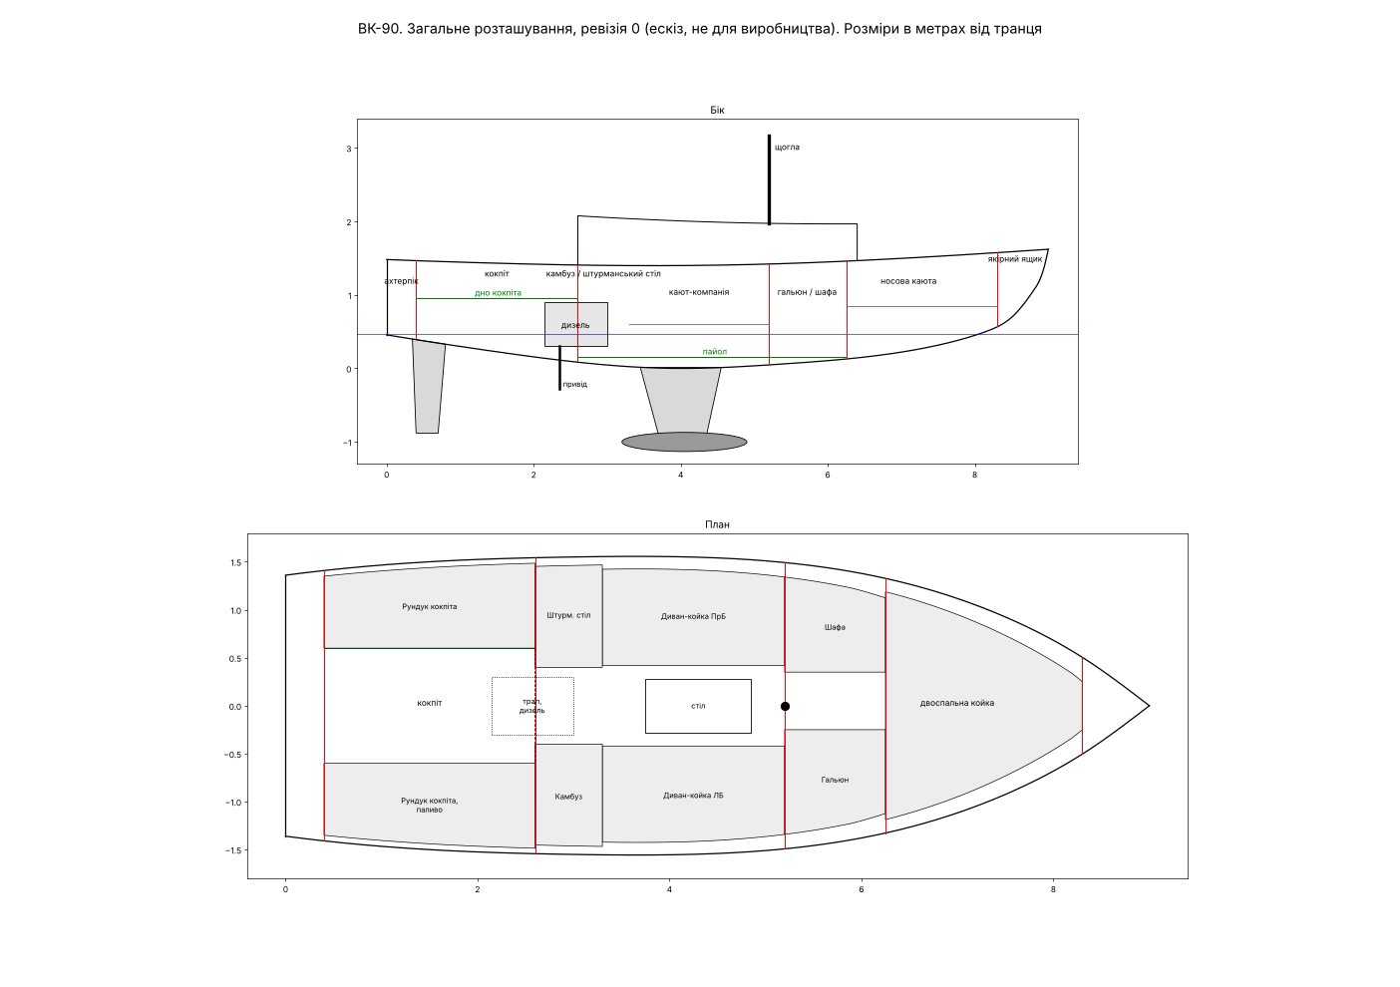
yacht/drawings/VK90-002_zahalne_roztashuvannia.png
