victorkolesnyk/trickymonkey/yacht/drawings/VK90-003_vitrylne_ozbroiennia.png

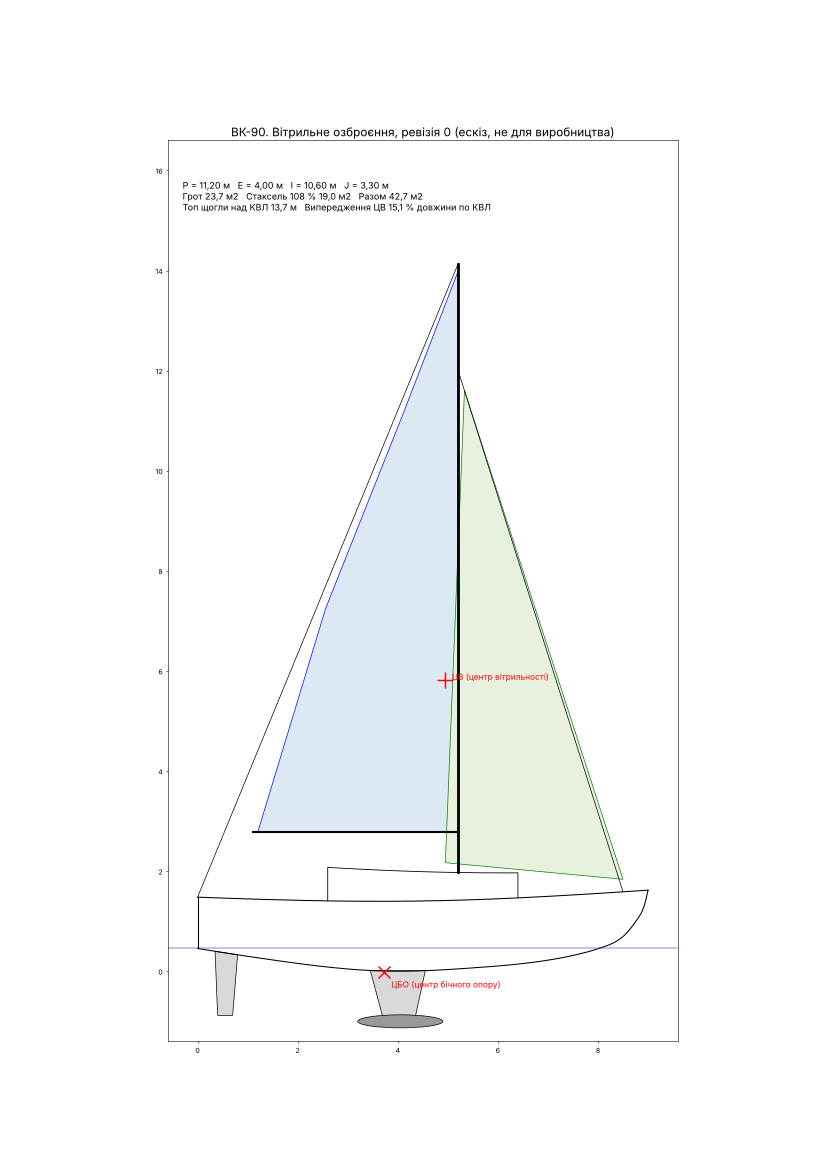
yacht/drawings/VK90-003_vitrylne_ozbroiennia.png
