victorkolesnyk/trickymonkey/yacht/drawings/VK90-002_003_roztashuvannia_ozbroiennia.dxf

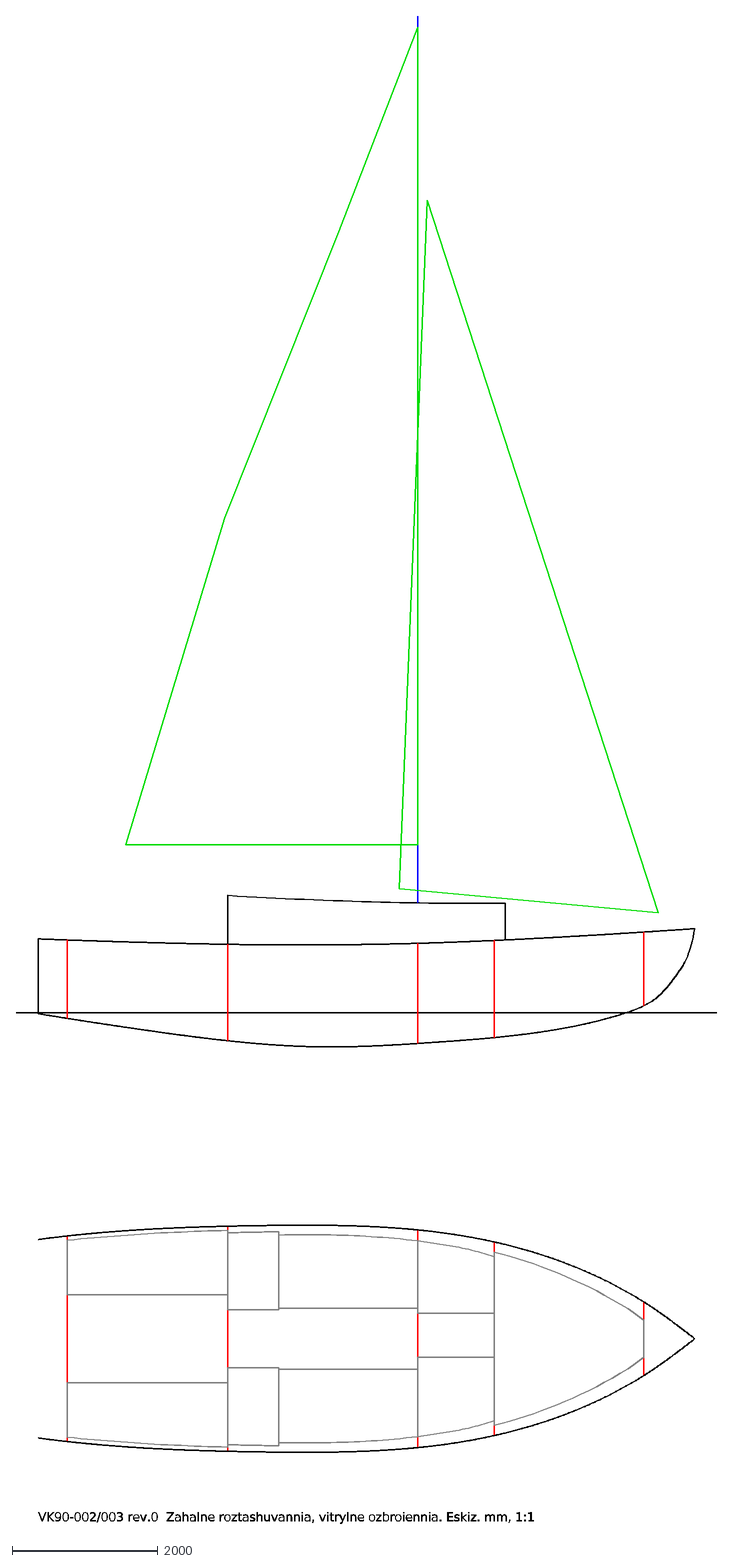
[picture p9: CAD file, 2026-11-13]
yacht/drawings/VK90-002_003_roztashuvannia_ozbroiennia.dxf
VK90-002/003 rev.0 Zahalne roztashuvannia, vitrylne ozbroiennia. Eskiz. mm, 1:1
