victorkolesnyk/trickymonkey/yacht/drawings/VK90-001_teoretychne_kreslennia.dxf

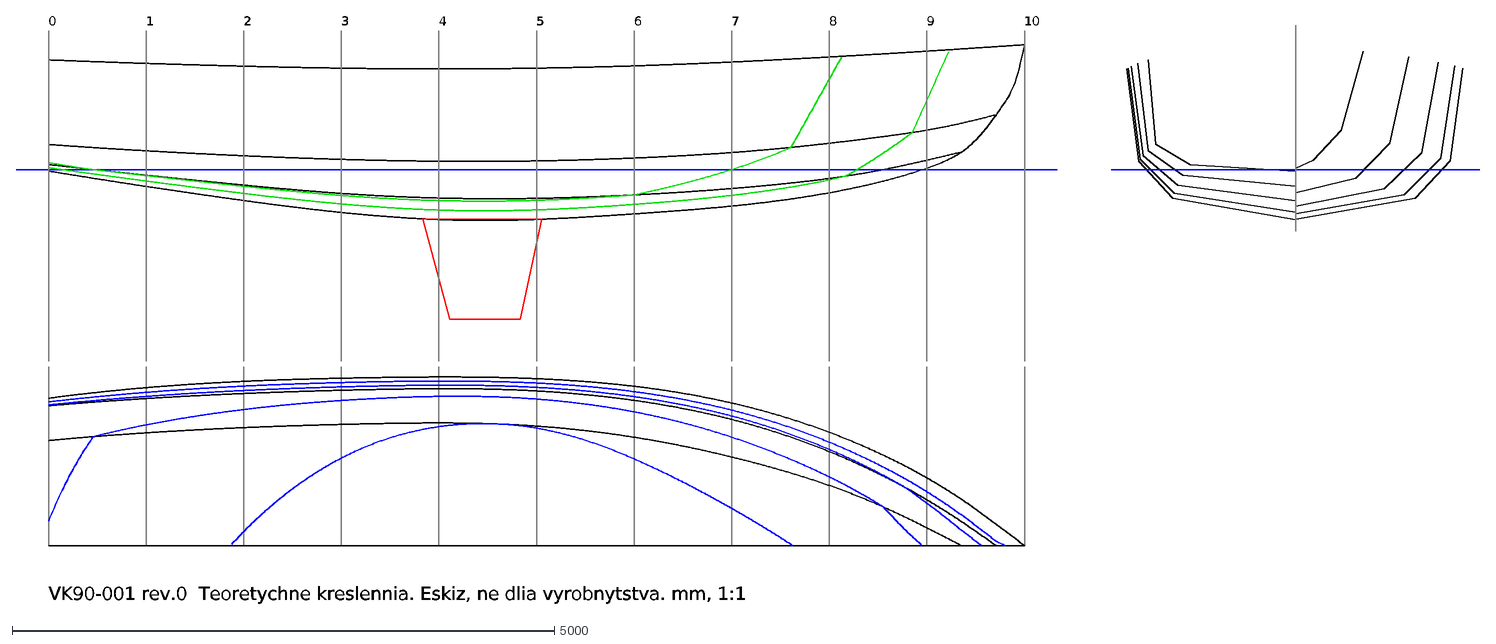
[picture p10: CAD file, 2026-11-13]
yacht/drawings/VK90-001_teoretychne_kreslennia.dxf
0
1
2
3
4
5
6
7
8
9
10
VK90-001 rev.0 Teoretychne kreslennia. Eskiz, ne dlia vyrobnytstva. mm, 1:1
