victorkolesnyk/trickymonkey/yacht/drawings/VK90-020_rozghortky_poperedni.dxf

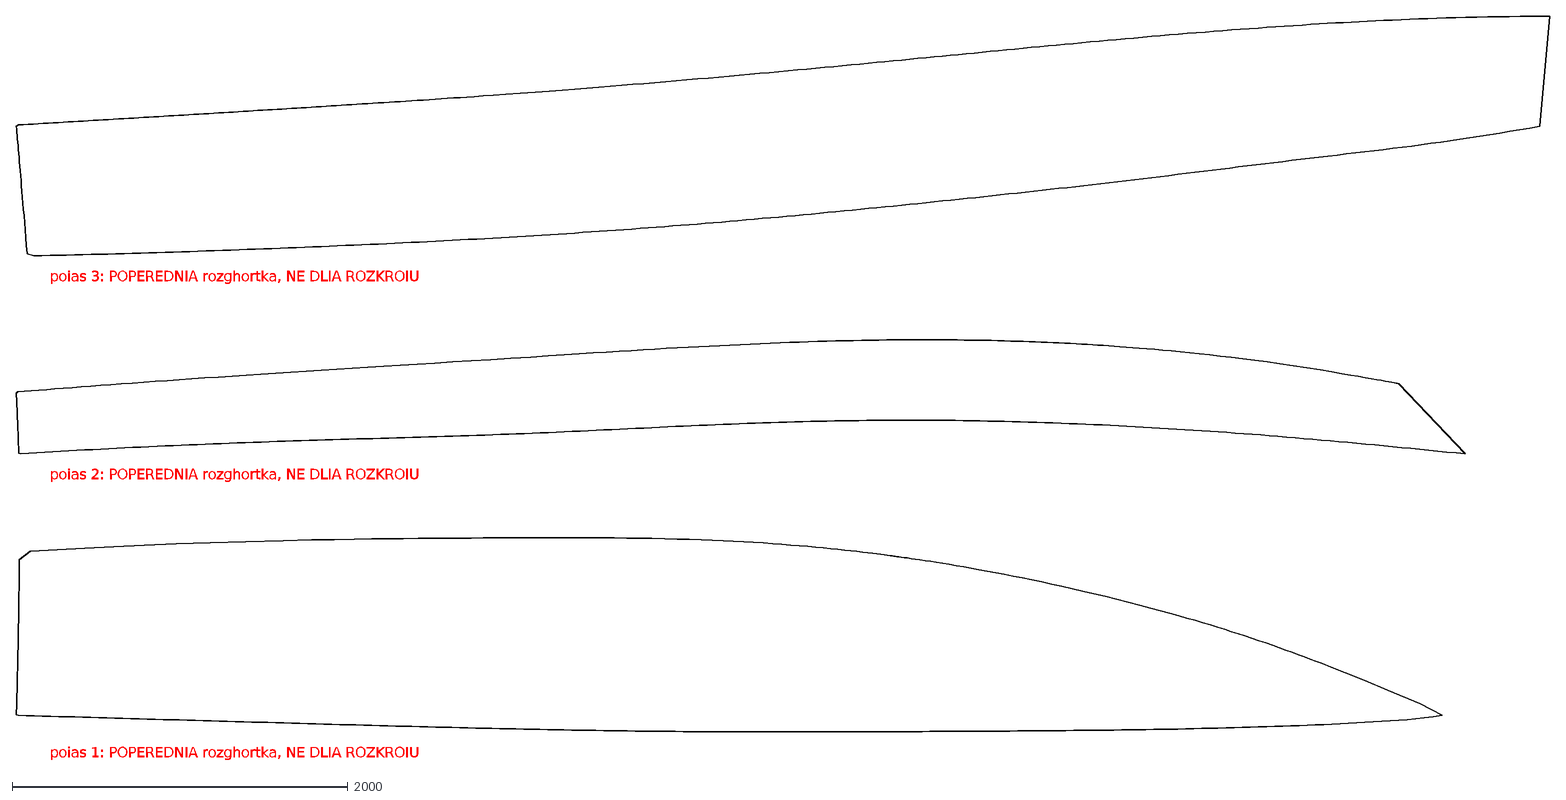
[picture p11: CAD file, 2026-11-13]
yacht/drawings/VK90-020_rozghortky_poperedni.dxf
poias 1: POPEREDNIA rozghortka, NE DLIA ROZKROIU
poias 2: POPEREDNIA rozghortka, NE DLIA ROZKROIU
poias 3: POPEREDNIA rozghortka, NE DLIA ROZKROIU
