victorkolesnyk/trickymonkey/yacht/drawings/VK90-002_zahalne_roztashuvannia.pdf

ВК-90. Загальне розташування, ревізія 0 (ескіз, не для виробництва). Розміри в метрах від транця

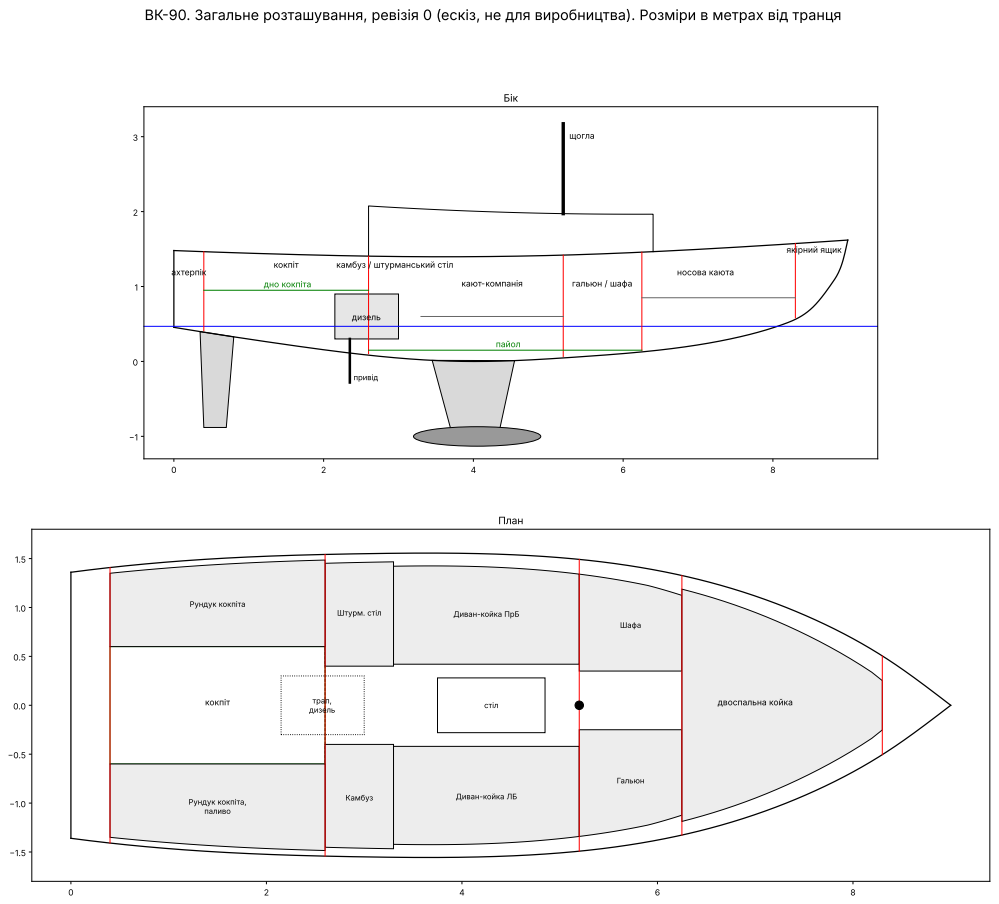
[picture p12: page 1]
пайол; дно кокпіта; дизель; привід; щогла; кокпіт; камбуз / штурманський стіл; кают-компанія; гальюн / шафа; носова каюта; якірний ящик; ахтерпік; Бік; Камбуз; Диван-койка ЛБ; Штурм. стіл; Гальюн; Шафа; Рундук кокпіта; Рундук кокпіта, паливо; План

Диван-койка ПрБ

двоспальна койка стіл трап,
дизель
