victorkolesnyk/trickymonkey/(commit log)

2026-11-12 Add VK-90 sailing cruiser preliminary design: brief, plan, hull model, lines plan
    Claude-Session: https://claude.ai/code/session_01KS2k6PftnWrNH862LrDTAT
2026-11-12 VK-90 stage 2: faired keel, panel developability check, centering, sail plan, general arrangement
    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
2026-11-13 VK-90 stage 3 (non-ISO part): aft lines rev 2 fully developable, free-trim stability with coachroof, keel and shroud loads
    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
2026-11-13 VK-90: keel bolt check against ISO 12215-9:2012 load case formulas (from Lyons et al. 2024)
    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
